877dev/smart-smoke-alarm/2020-07-04 15.22.59.jpg

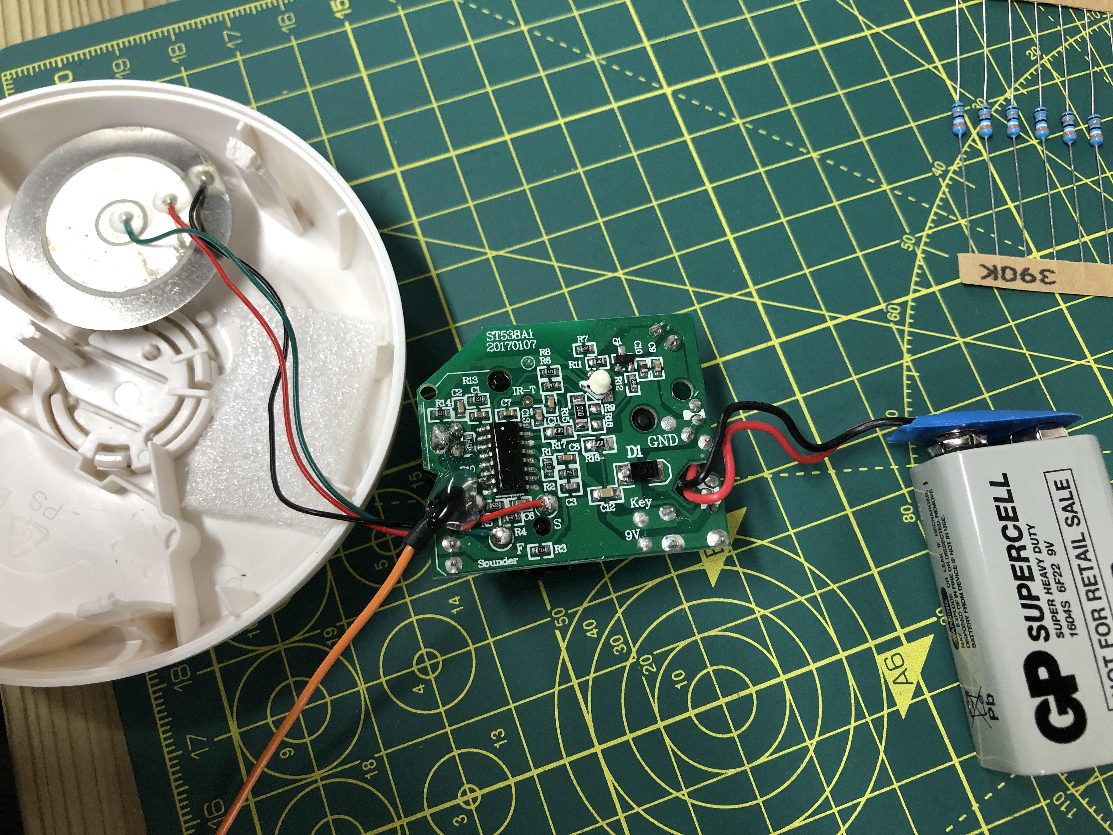
2020-07-04 15.22.59.jpg
