877dev/smart-smoke-alarm/2020-07-04 15.23.05.jpg

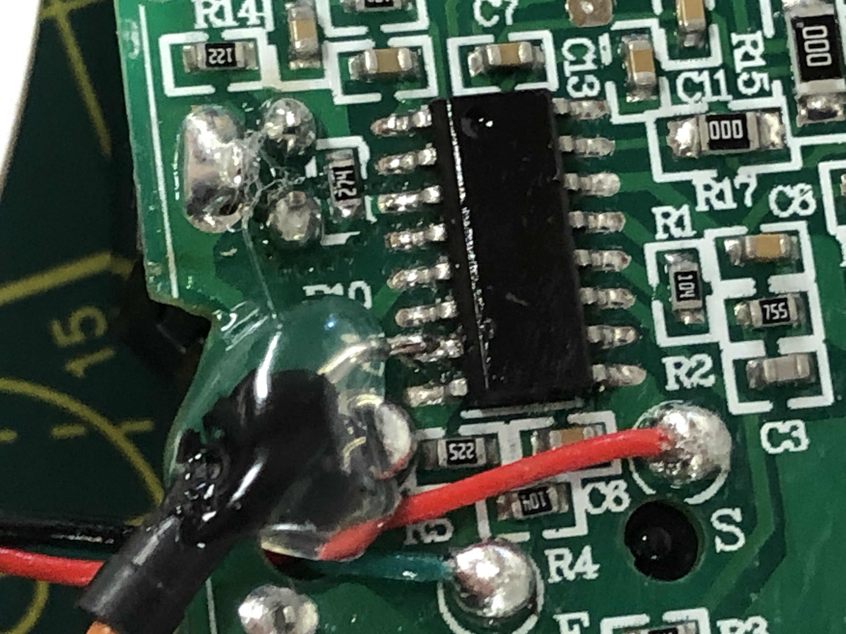
2020-07-04 15.23.05.jpg
