877dev/smart-smoke-alarm/2020-07-04 15.31.51.jpg

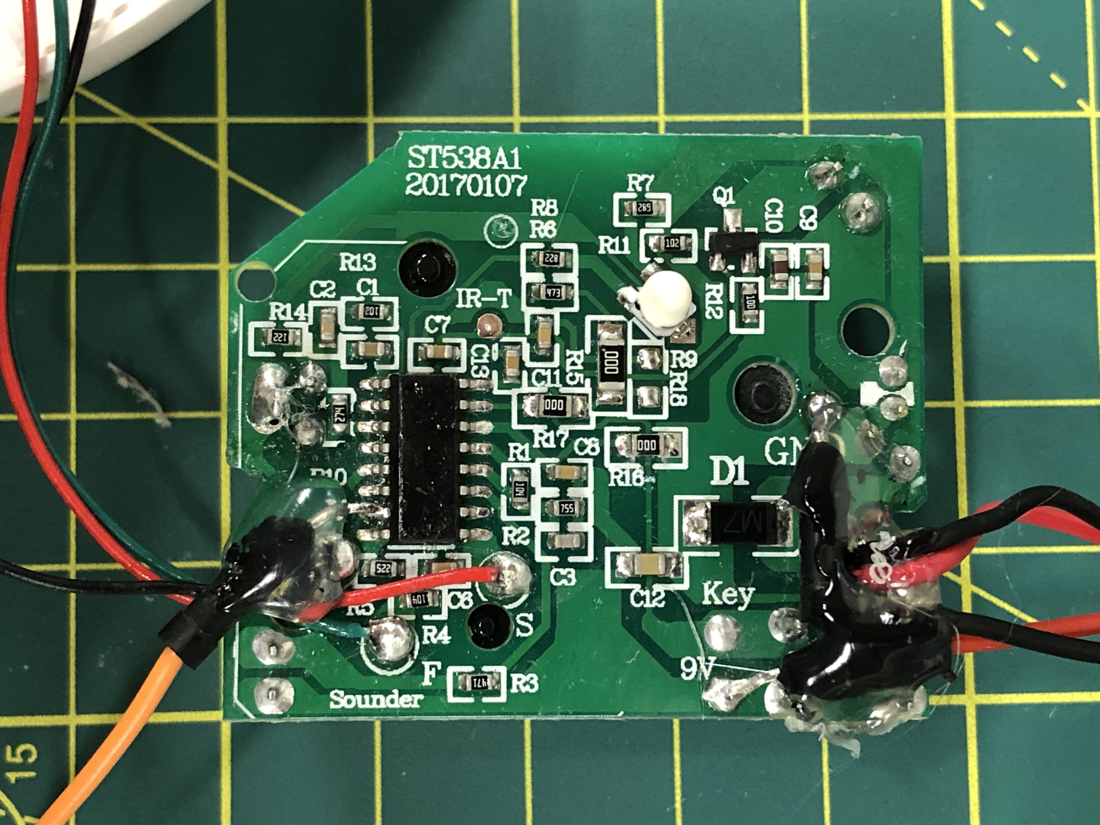
2020-07-04 15.31.51.jpg
