877dev/smart-smoke-alarm/2020-07-04 15.33.00.jpg

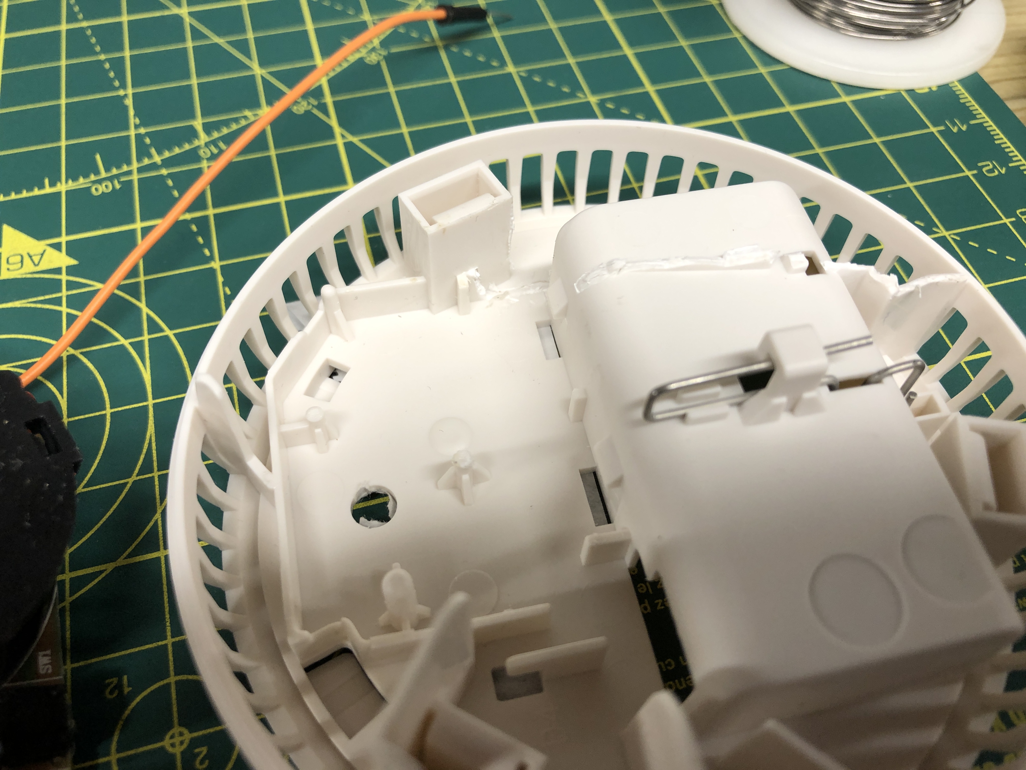
2020-07-04 15.33.00.jpg
