877dev/smart-smoke-alarm/2020-07-04 16.11.36.jpg

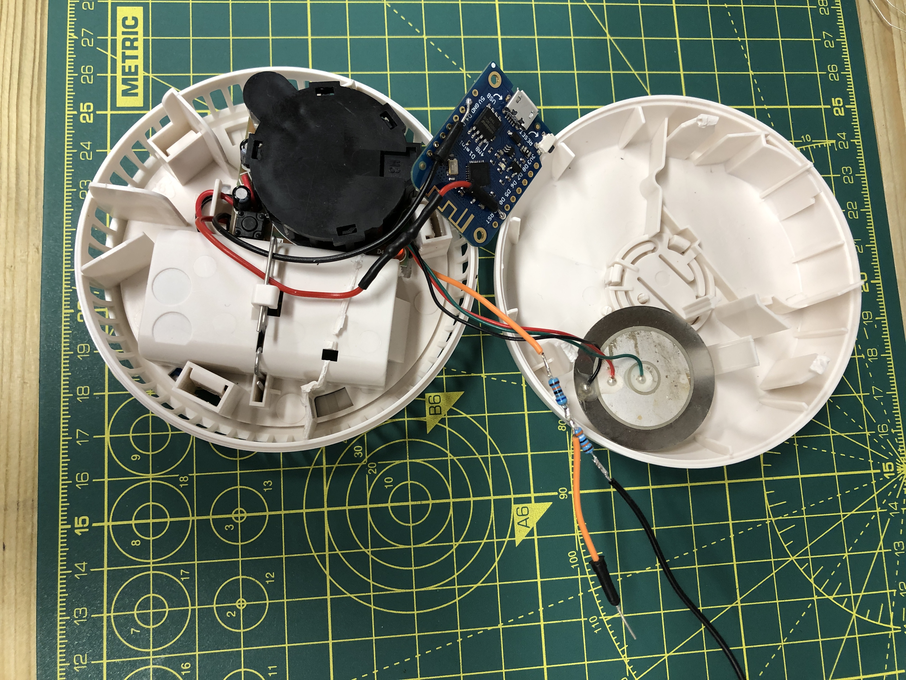
2020-07-04 16.11.36.jpg
