877dev/smart-smoke-alarm/Battery monitoring circuit.png

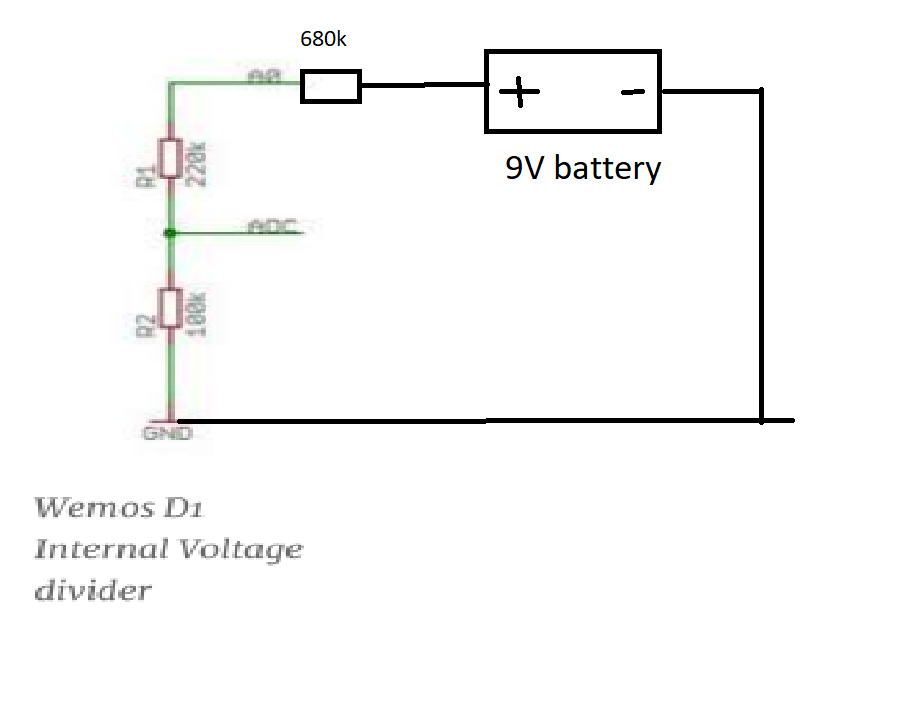
Battery monitoring circuit.png
