877dev/smart-smoke-alarm/ESP8266 best pins to use.png

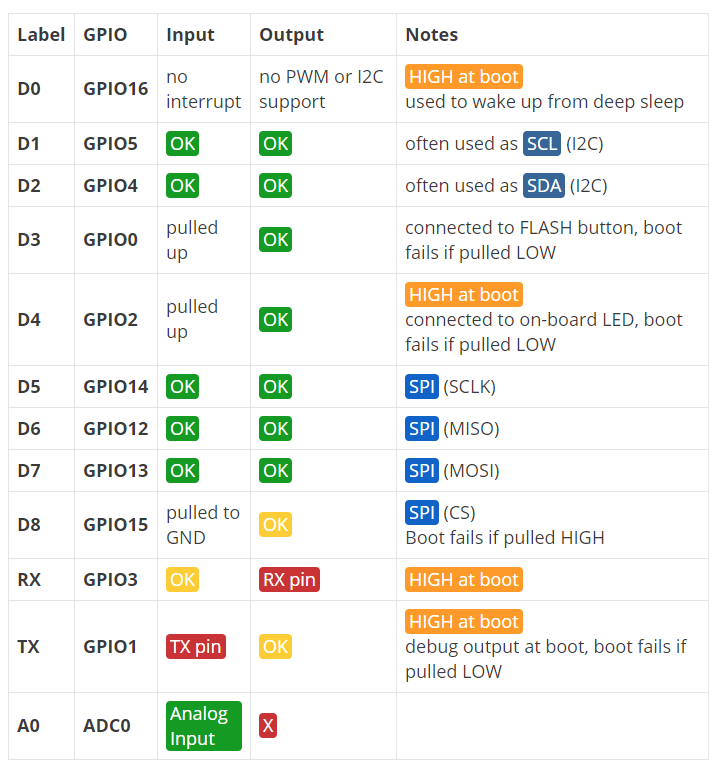
ESP8266 best pins to use.png
