877dev/smart-smoke-alarm/ESP8266 logic levels.png

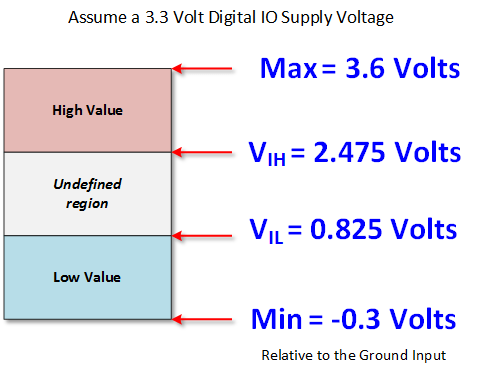
ESP8266 logic levels.png
