877dev/smart-smoke-alarm/Volts high battery.PNG

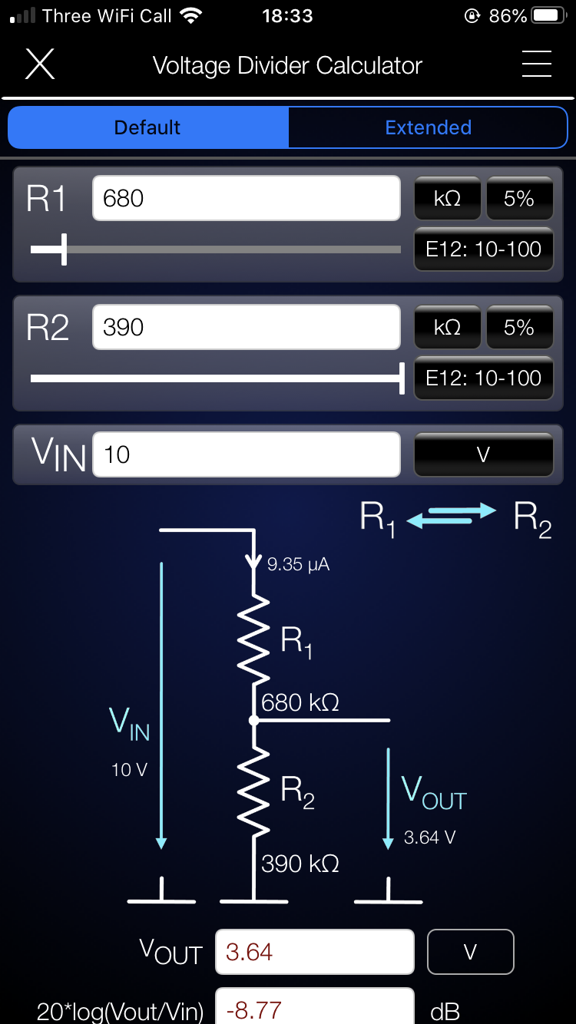
Volts high battery.PNG
