877dev/smart-smoke-alarm/Existing wiring.jpg

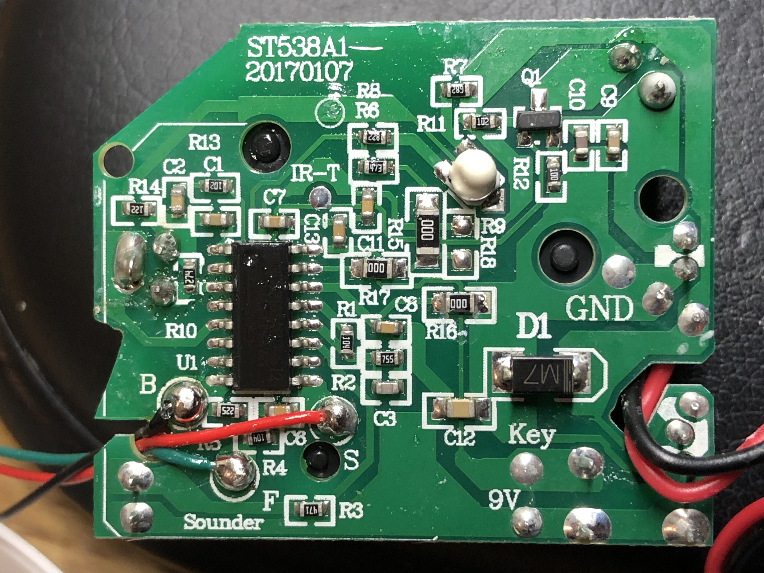
Existing wiring.jpg
