877dev/smart-smoke-alarm/v001_smoke_alarm_mqtt_github/mqtt.ino

void MQTT_Connect()
{
  Serial.print("Connecting to MQTT...  ");
  // We'll connect with a Retained Last Will that updates the '.../Status' topic with "Dead" when the device goes offline...
  // Attempt to connect...
  /*
    MQTT Connection syntax:
    boolean connect (client_id, username, password, willTopic, willQoS, willRetain, willMessage)
    Connects the client with a Will message, username and password specified.
    Parameters
    client_id : the client ID to use when connecting to the server.
    username : the username to use. If NULL, no username or password is used (const char[])
    password : the password to use. If NULL, no password is used (const char[])
    willTopic : the topic to be used by the will message (const char[])
    willQoS : the quality of service to be used by the will message (int : 0,1 or 2)
    willRetain : whether the will should be published with the retain flag (int : 0 or 1)
    willMessage : the payload of the will message (const char[])
    Returns
    false - connection failed.
    true - connection succeeded
  */
  if (MQTTclient.connect(mqtt_client_id.c_str(), mqtt_username, mqtt_password, (base_mqtt_topic + "/Status").c_str(), 0, 1, "Dead"))
  {
    // We get here if the connection was successful...
    mqtt_connect_count++;
    Serial.println("CONNECTED!");
    // Once connected, publish some announcements...
    // These all have the Retained flag set to true, so that the value is stored on the server and can be retrieved at any point
    // Check the .../Status topic to see that the device is still online before relying on the data from these retained topics
    MQTTclient.publish((base_mqtt_topic + "/Status").c_str(), "Alive", true);
    MQTTclient.publish((base_mqtt_topic + "/MAC_Address").c_str(), WiFi.macAddress().c_str(), true);                 // Device MAC Address
    MQTTclient.publish((base_mqtt_topic + "/MQTT_Connect_Count").c_str(), String(mqtt_connect_count).c_str(), true); // MQTT Connect Count
    MQTTclient.publish((base_mqtt_topic + "/alarm").c_str(), String("false").c_str(), true);   //set alarm to false initially
    MQTTclient.loop();


    // ... and then re/subscribe to the watched topics
    //MQTTclient.subscribe((base_mqtt_topic + "/TOPIC").c_str());   // Watch the .../TOPIC topic for incoming MQTT messages
    //MQTTclient.loop();
    // Add other watched topics in here...
  }
  else
  {
    // We get here if the connection failed...
    Serial.print("MQTT Connection FAILED, Return Code = ");
    Serial.println(MQTTclient.state());
    Serial.println();
    /*
      MQTTclient.state return code meanings...
      -4 : MQTT_CONNECTION_TIMEOUT - the server didn't respond within the keepalive time
      -3 : MQTT_CONNECTION_LOST - the network connection was broken
      -2 : MQTT_CONNECT_FAILED - the network connection failed
      -1 : MQTT_DISCONNECTED - the client is disconnected cleanly
      0 : MQTT_CONNECTED - the client is connected
      1 : MQTT_CONNECT_BAD_PROTOCOL - the server doesn't support the requested version of MQTT
      2 : MQTT_CONNECT_BAD_CLIENT_ID - the server rejected the client identifier
      3 : MQTT_CONNECT_UNAVAILABLE - the server was unable to accept the connection
      4 : MQTT_CONNECT_BAD_CREDENTIALS - the username/password were rejected
      5 : MQTT_CONNECT_UNAUTHORIZED - the client was not authorized to connect *
    */
  }
} // End of void MQTT_Connect
