877dev/smart-smoke-alarm/v001_smoke_alarm_mqtt_github/notes.ino

//v001 smoke_alarm
//
//See github for full details https://github.com/877dev/smart-smoke-alarm
//
//NOTE - TRY THIS AT YOUR OWN RISK, ALWAYS HAVE A BACKUP UN-MODIFIED SMOKE ALARM AS A BACKUP.
//
//
//**********************************************************************************************
//Secret credentials example (save as .h file on your PC):
//
//Wifi Credentials
#define mySSID "your_ssid"
#define myPASSWORD "your_password"

//ArduinoOTA password
#define myOTApassword "your_ota_password"

//MQTT Credentials
#define myMqttIP (192, x, x, x)
#define myMqttPort 1883
#define myMqttUser "your_mqtt_user"
#define myMqttPassword "your_mqtt_password"

//Add this line to your sketch
//#include <C:\arduino\secret_credentials.h>  //or whatever filename/directory you want
//*********************************************************************************************
